TheRealMal/motor-controller/docs/src/Руководство_администратора.docx

Московский государственный технический университет им. Н.Э. Баумана

Контроллер шагового и асинхронного двигателей.

Руководство администратора.

РОФ.МГТУ.000001-01 5

Подп. и дата
Инв. N дубл.
Взам. Инв. N
Подп. и дата
Инв. N подп.

Листов 4

Проверил | | | Рафиков А.Г.
| | (подпись, дата)

Разработал | | | Малютин Р.С.
| | (подпись, дата)

| | | Храпов Н.А.
| | (подпись, дата)

ОГЛАВЛЕНИЕ

1 НАЗНАЧЕНИЕ И УСЛОВИЯ ПРИМЕНЕНИЯ ПРОГРАММЫ

  1.1 Назначение программы

Основной функцией программы является управление шаговым и асинхронным двигателем.

Основная задача программы – реализация универсального управления двигателями.

Программа реализует следующие функции:

Исходным языком программирования для аппаратной программы является C. Программа обеспечивает обработку команд и управление шаговым и асинхронным двигателями.

Программа реализует следующие функции:

- вращение двигателей в заданном пользователем направлении
- вращение двигателей заданной пользователем скоростью
- поворот двигателей на определенный пользователем угол

Функции программы позволяют обеспечить работу системы в автономном режиме.

  1.2 Условия, необходимые для выполнения программы
    1.2.1 Требования к составу периферийных устройств

Для функционирования ПО и взаимодействия с ПО требуется наличие локальной вычислительной сети.

    1.2.2 Требования к параметрам периферийных устройств

Никаких требований к параметрам периферийных устройств программа не предъявляет.

    1.2.3 Требования к программному обеспечению

Для запуска веб-интерфейса требуется ОС любого семейства с наличием веб-браузера (Chrome, Firefox и т.п.).

1 ВЫПОЛНЕНИЕ ПРОГРАММЫ

Для выполнения программы необходимо подключить питание к аппаратному устройству, программа будет работать в автономном режиме.

Для управления одним из двигателей необходимо отправить TCP запрос на устройство, что можно сделать, используя разработанный интерфейс.

2 ОБРАЩЕНИЕ К ПРОГРАММЕ
  2.1 Настройка информационной системы

Администратору для настройки необходимо осуществить следующие действия:

- Убедиться в доступности локальной вычислительной сети
- Заранее сконфигурировать данную сеть, либо получить учетные данные для доступа к ней
- Запустить устройство и определить его IP адрес
- Ввести определенный IP адрес в интерфейсе

При отсутствие установить веб-браузер на устройство, с которого будет происходить управление через веб-интерфейс.

  2.2 Завершение работы программы

Программа завершает работу при выключении устройства.

3 СООБЩЕНИЯ АДМИНИСТРАТОРУ

Сообщения аналогичны сообщениям описанным в документе “Руководство пользователя”
