TheRealMal/motor-controller/docs/Структурная_схема_ПО.pdf

| | | | РОФ.МГТУ.00001.001 СС
| | | | | Лит. | Масса | Масштаб
Изм. Лист | № докум. | Подп. | Дата
Разраб.
Пров. | Рафиков А.Г.
Т.контр. | | | | Лист | Листов 1
| | | | МГТУ им. Н.Э. Баумана ИУ8-72
Н.контр.
Утв.
Копировал: | Формат А3

## main

## SPI_Ethernet_doPacket

## parse_command

motor_type | handle_stepper

## handle_async

## команда для шагового двигателя

## команда для асинхронного двигателя

## статус выполнения
