TheRealMal/motor-controller/docs/РОФ_МГТУ_00001_001_01_Схема_электрическая_структурная.pdf

| | | | РОФ.МГТУ.00001.001
| | | | | Лит. | Масса | Масштаб
Изм. Лист | № докум. | Подп. | Дата
Разраб.
Пров. | Рафиков А.Г.
Т.контр. | | | | Лист | Листов 1
| | | | МГТУ им. Н.Э. Баумана ИУ8-72
Н.контр.
Утв.
Копировал: | Формат А3

# Микроконтроллер PIC18F45K22

# ENC28J60

# Шаговый двигатель

# Асинхронный двигатель

Обратная связь

Обратная связь

Сигнал для управления
асинхронным двигателем

Сигнал для управления
шаговым двигателем Результаты выполнения команд

Команды для
двигателей
