TheRealMal/motor-controller/docs/МГТУ_000001_001_ЭЗ.pdf

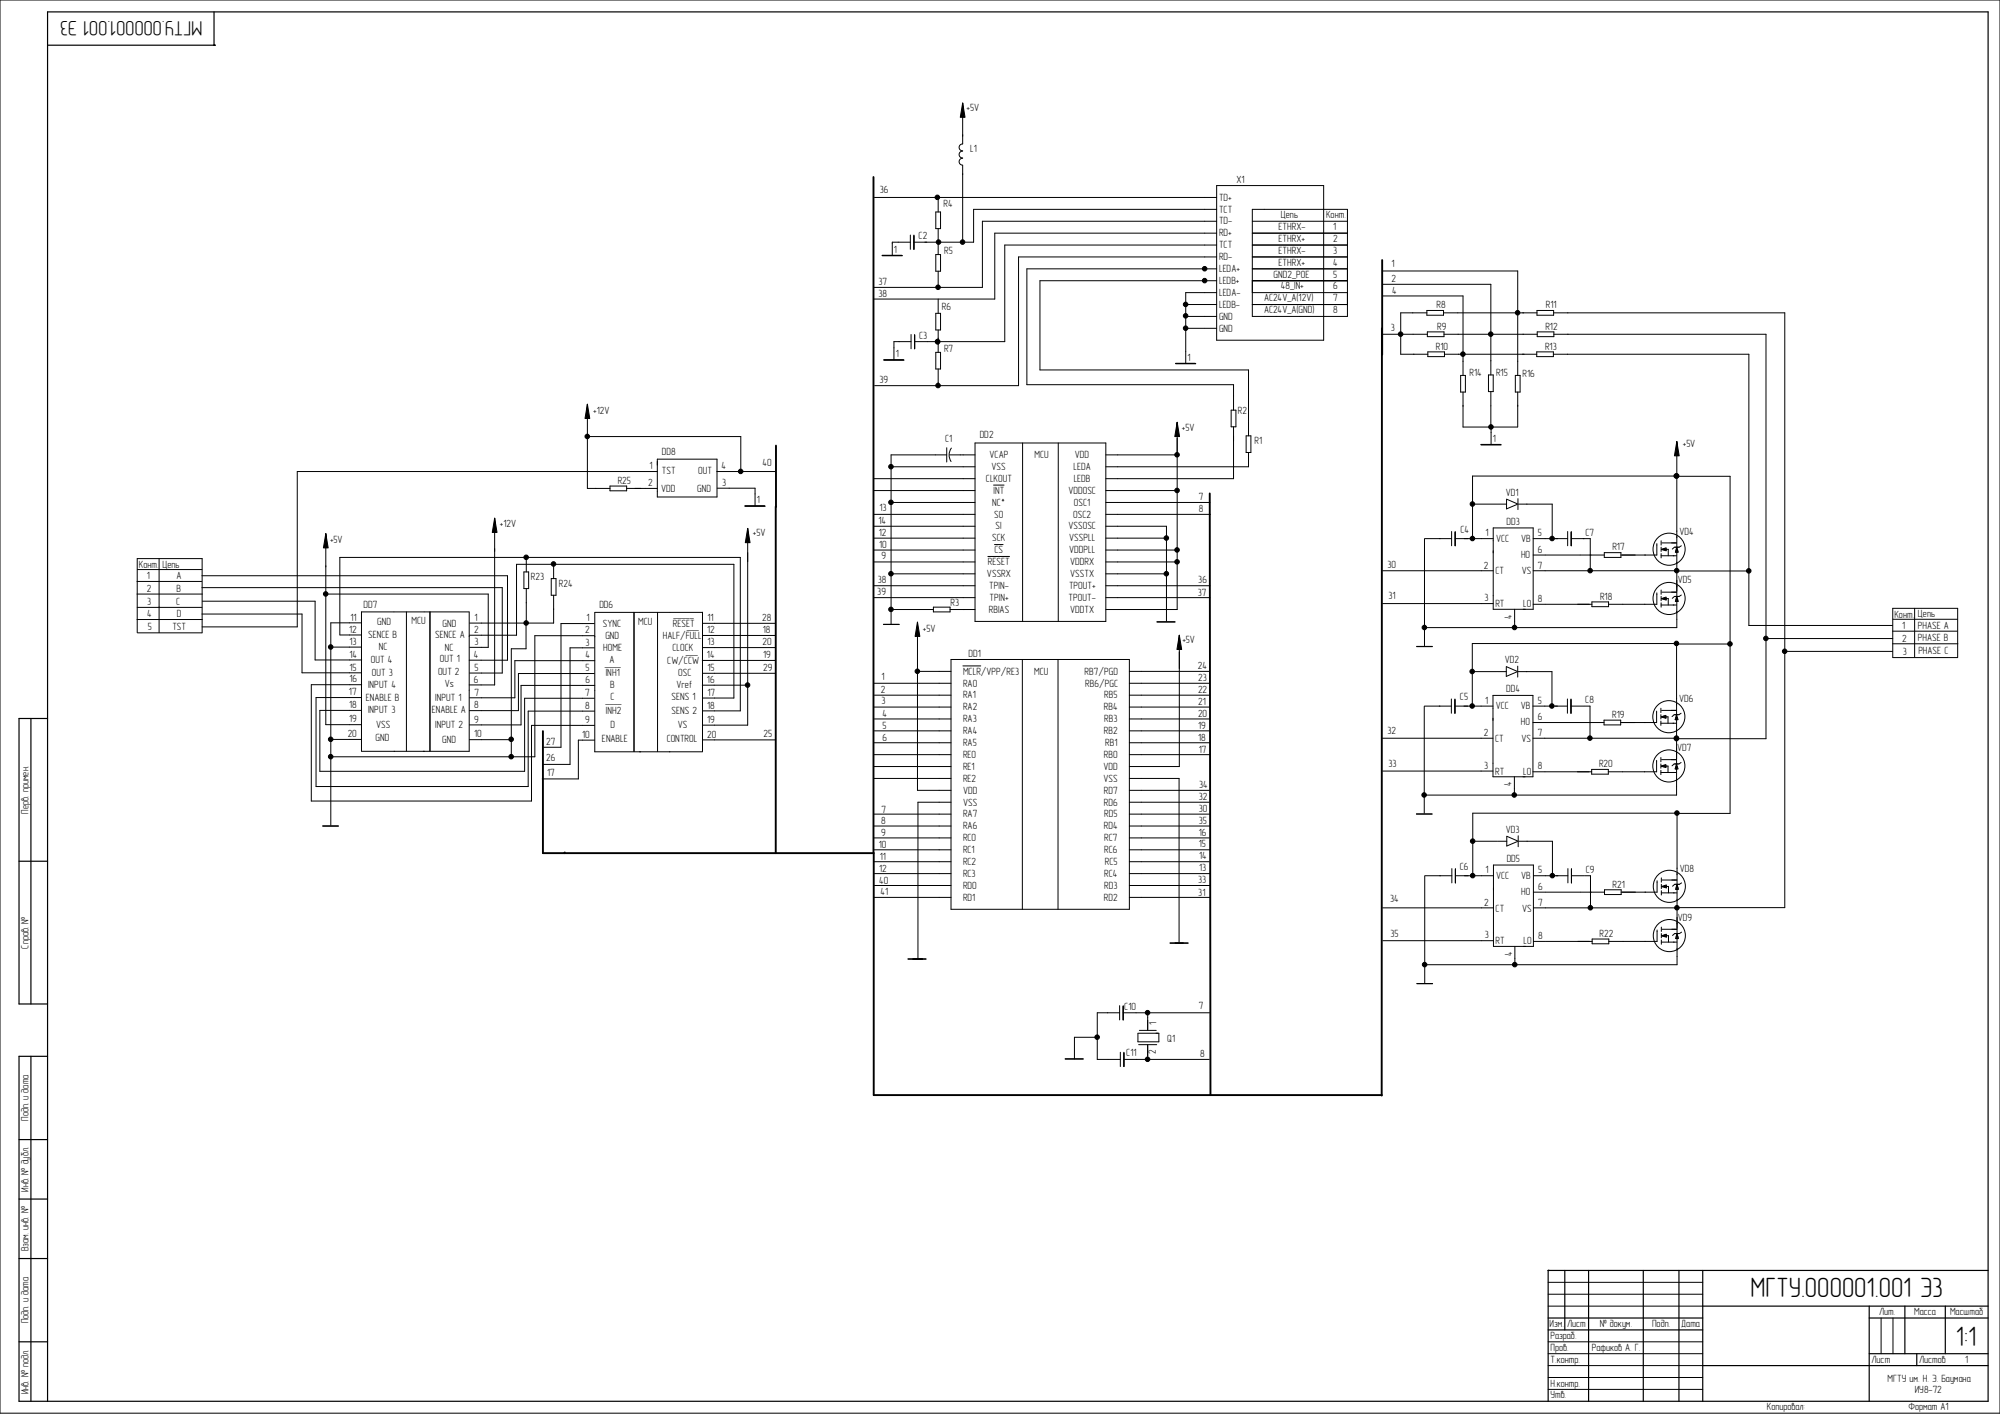
[picture p4: page 1]

Цепь ETHRX+ | Конт. 12345678
ETHRX-

ETHRX+

AC24V_A(12V)
AC24V_A(GND)

VCAP VSS CLKOUT | MCU | VDD LEDA LEDB VDDOSC OSC1 OSC2 VSSOSC VSSPLL VDDPLL VDDRX VSSTX TPOUT+ TPOUT-VDDTX

13
14 | | 36

ABC

19
18
17

32
30

10 | | 15
11 | | 14

МГТУ.000001.001 Э3

Лит. | Масса | Масштаб

Изм. Лист | № докум. | Подп. | Дата
Разраб.
Пров.
Т.контр. | | | | | 1

Н.контр.
Утв.

МГТУ им. Н. Э. Баумана ИУ8-72
