TheRealMal/motor-controller/docs/МГТУ_000001_001_Спецификация.PDF

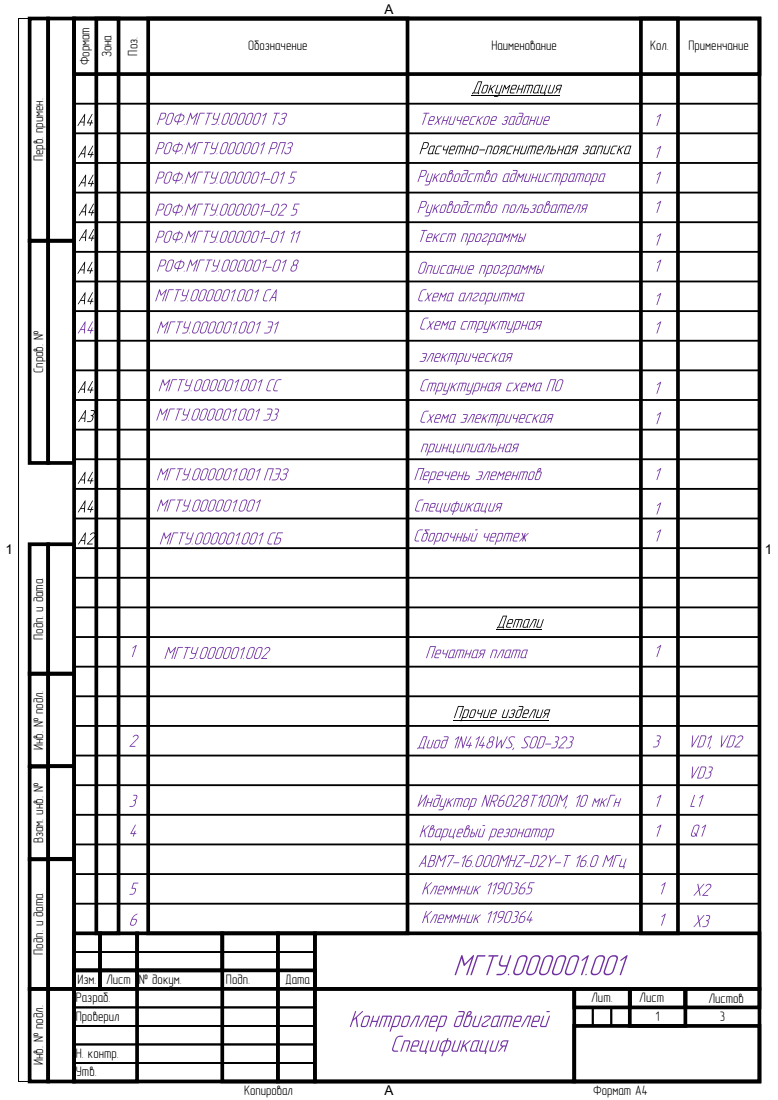
[picture p5: page 1]

Перв. примен. Справ. № Подп. и дата Инв. № подл. Взам. инв. № Подп. и дата Инв. № подл.

Изм. | Лист | № докум. | Подп. | Дата
Разраб. | | | Лит. | Лист | Листов
Проверил

Н. контр.
Утв.

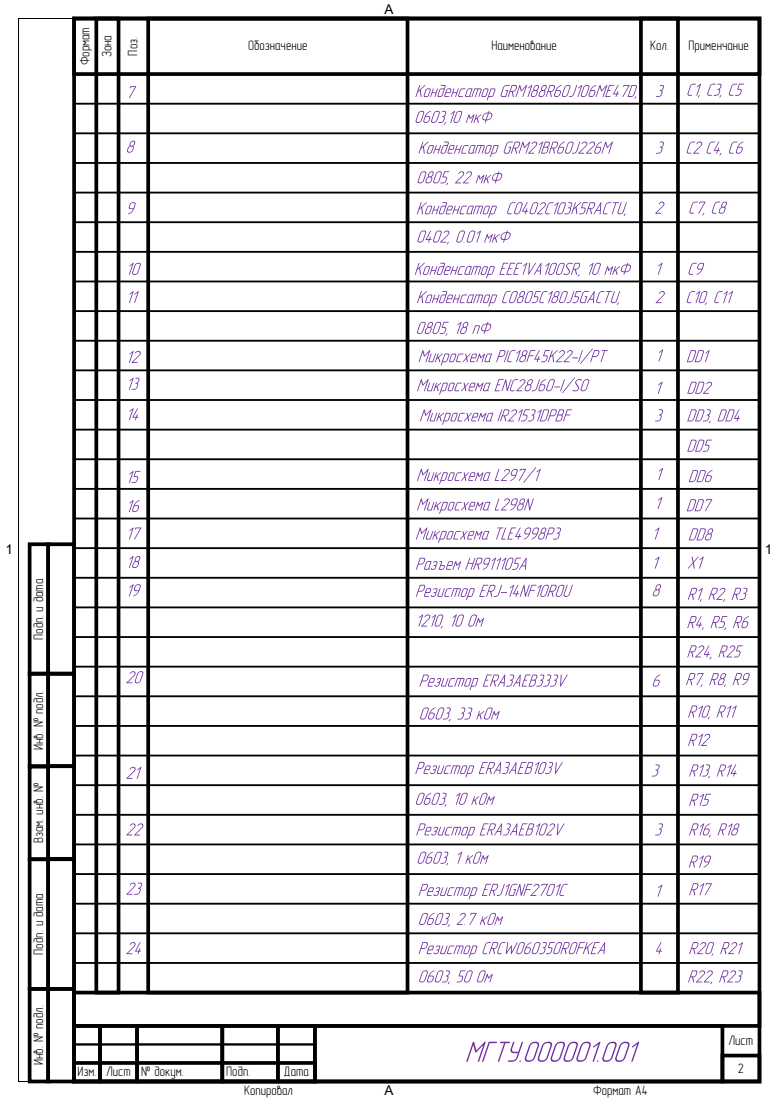
[picture p6: page 2]

Подп. и дата Инв. № подл. Взам. инв. № Подп. и дата Инв. № подл.

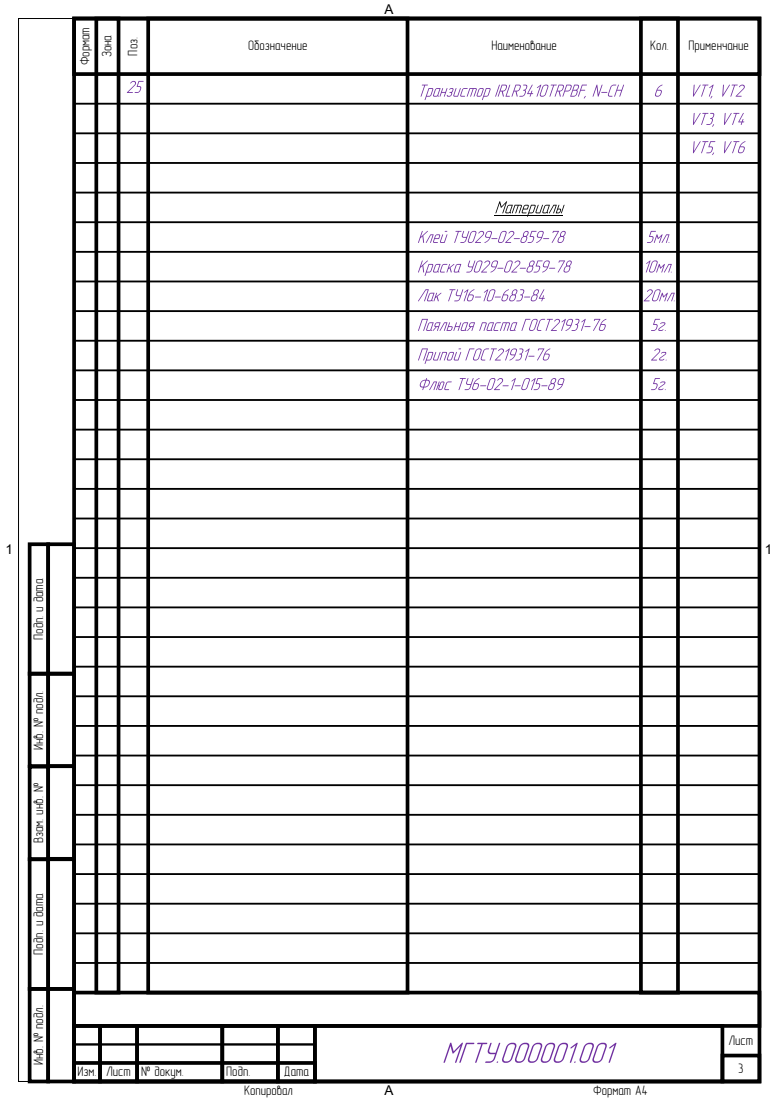
[picture p7: page 3]

Подп. и дата Инв. № подл. Взам. инв. № Подп. и дата Инв. № подл.
