TheRealMal/motor-controller/docs/МГТУ_000001_001_CБ.PDF

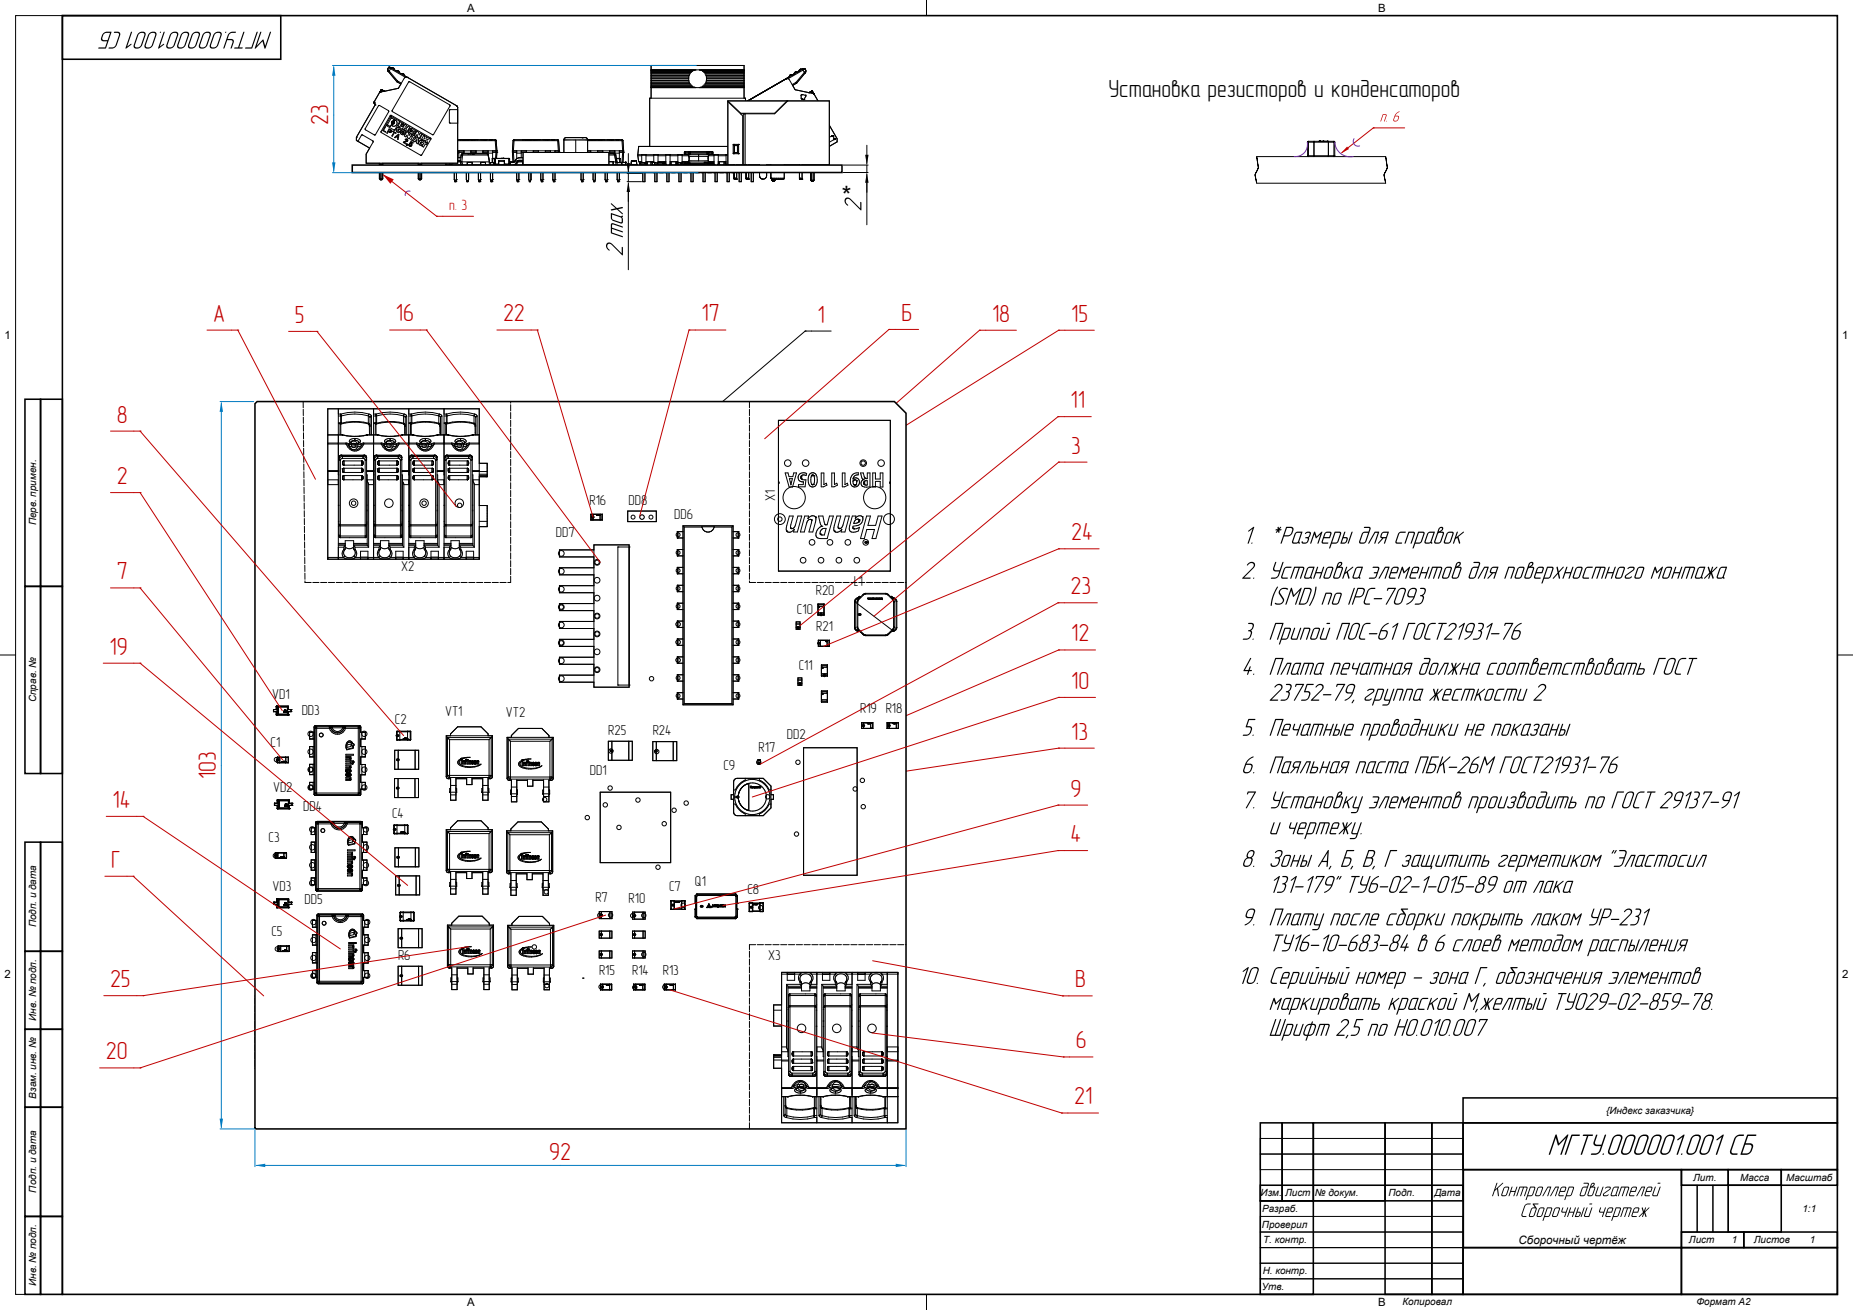
[picture p8: page 1]

Перв. примен. Справ. № Подп. и дата Инв. № подл. Взам. инв. № Подп. и дата Инв. № подл.
