TheRealMal/motor-controller/docs/МГТУ_000001_001_ПЭЗ.PDF

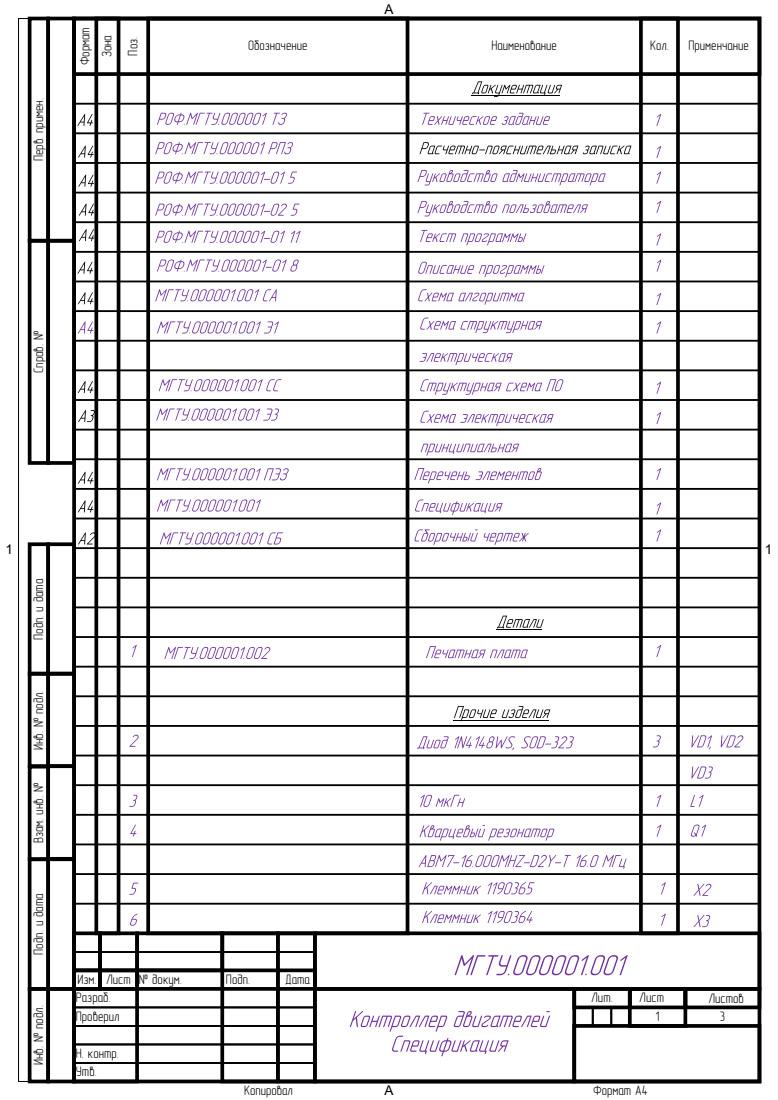
[picture p9: page 1]

Перв. примен. Справ. № Подп. и дата Инв. № подл. Взам. инв. № Подп. и дата Инв. № подл.

Изм. | Лист | № докум. | Подп. | Дата
Разраб. | | | Лит. | Лист | Листов
Проверил

Н. контр.
Утв.


Подп. и дата Инв. № подл. Взам. инв. № Подп. и дата Инв. № подл.


Подп. и дата Инв. № подл. Взам. инв. № Подп. и дата Инв. № подл.
