TheRealMal/motor-controller/docs/МГТУ_000001_002_ПП.pdf

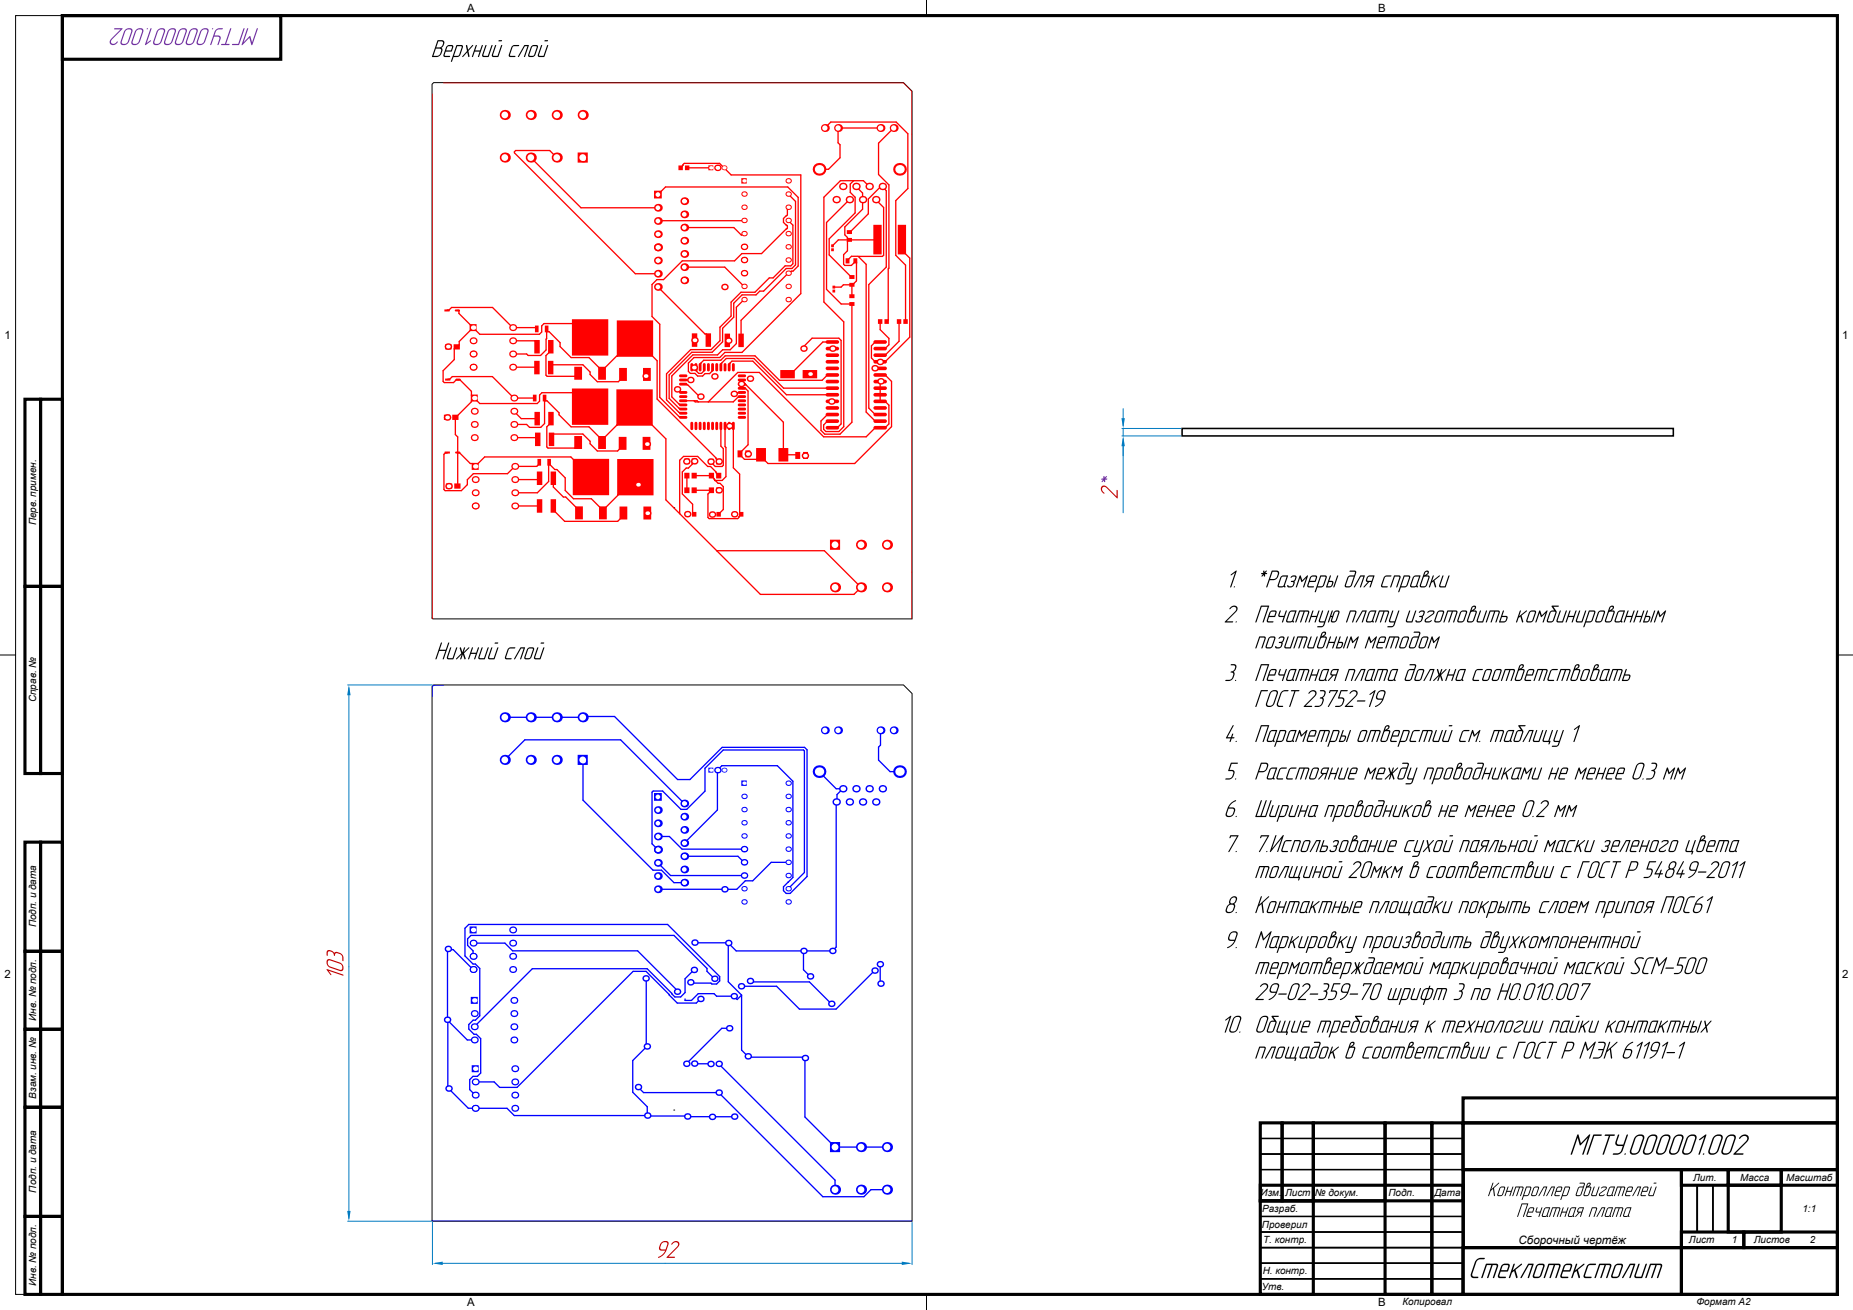
[picture p10: page 1]

Перв. примен. Справ. № Подп. и дата Инв. № подл. Взам. инв. № Подп. и дата Инв. № подл.

Сборочный чертёж | Лит. | Масса | Масштаб

Изм. Лист | № докум. | Подп. | Дата
Разраб.
Проверил
Т. контр. | | | | Лист 1 | Листов 2

Н. контр.
Утв.

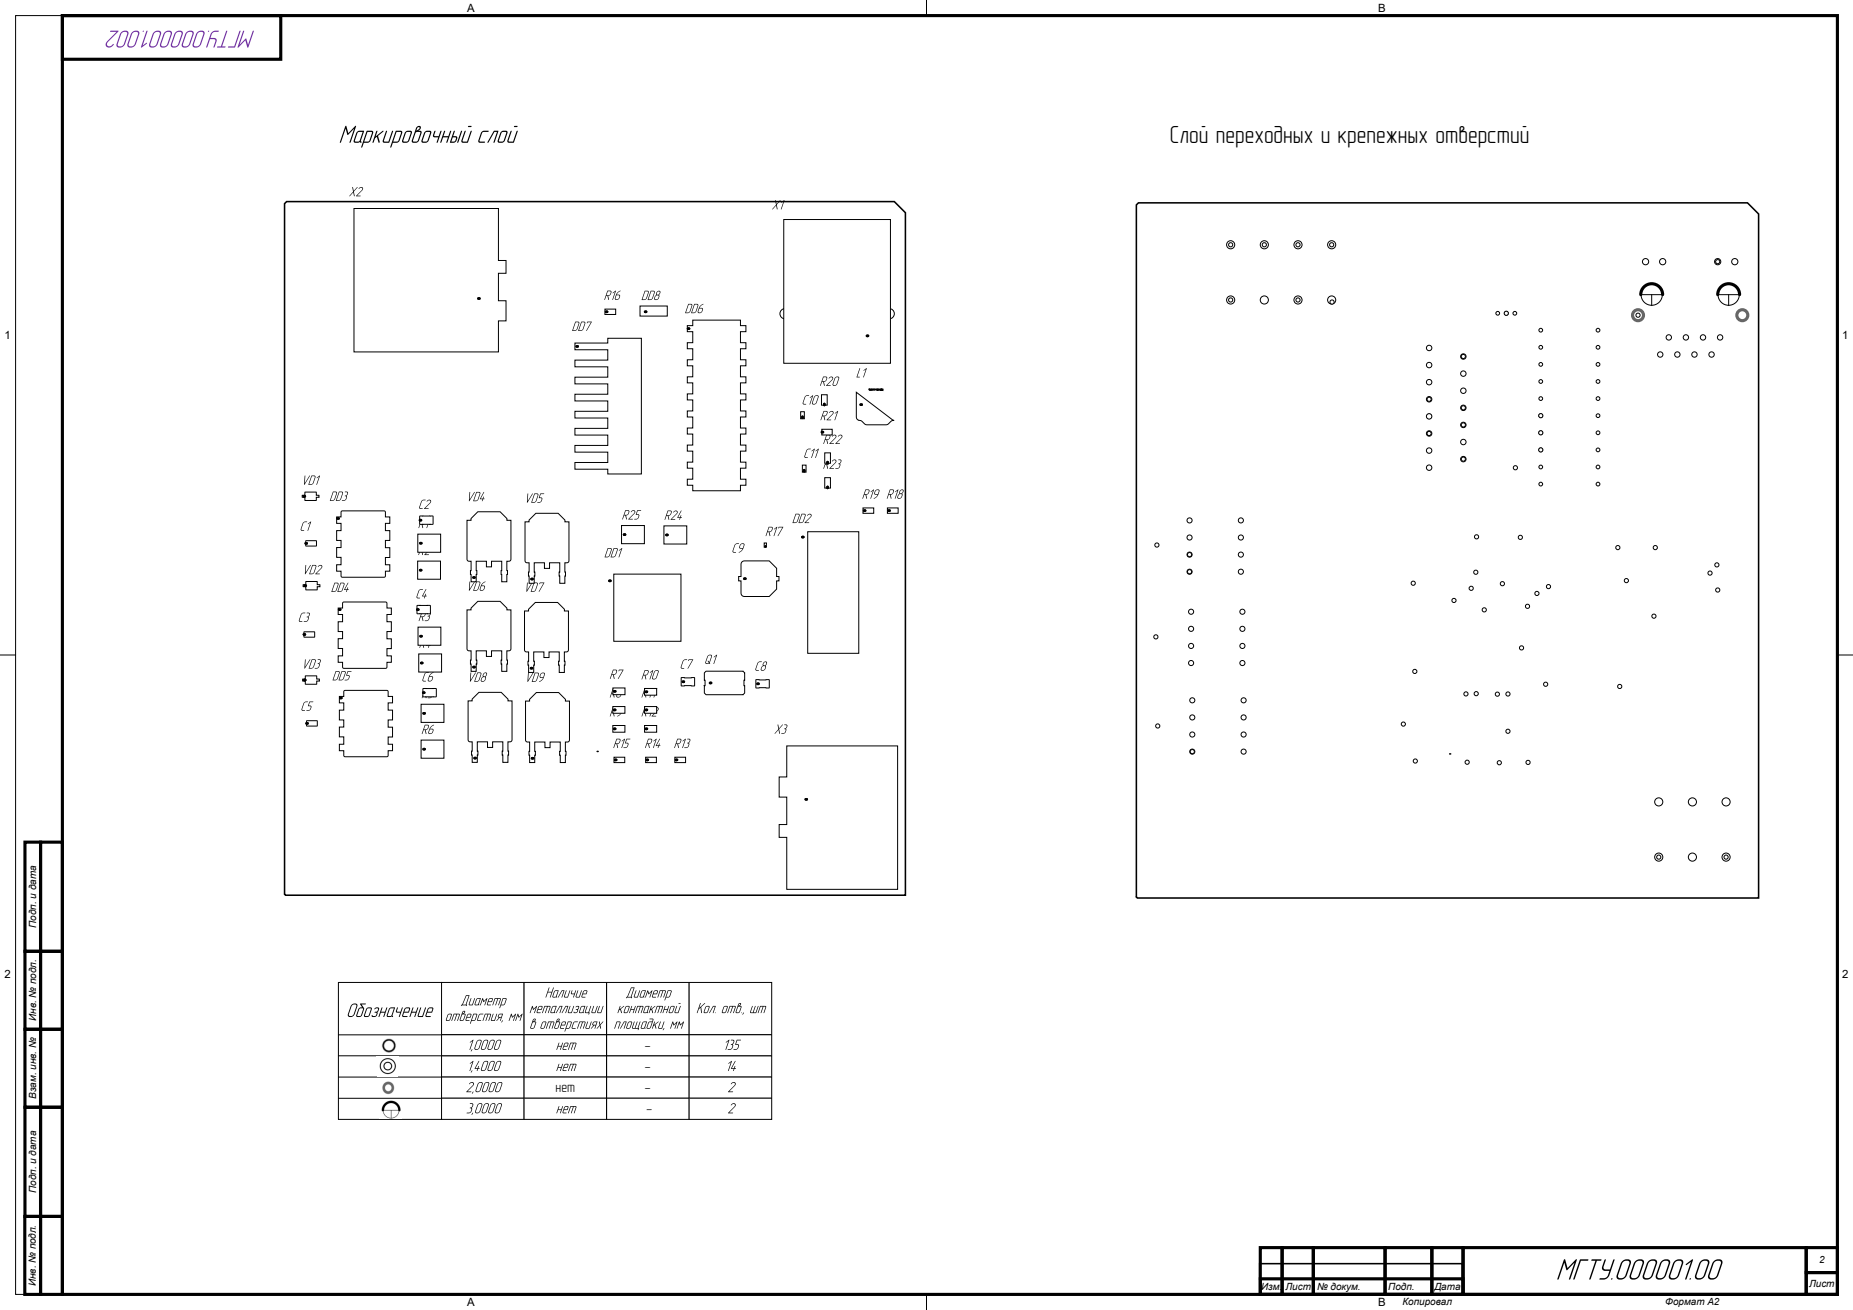
[picture p11: page 2]

Слой переходных и крепежных отверстий

Подп. и дата Взам. инв. № Подп. и дата Инв. № подл.

нет
