TheRealMal/motor-controller/(list of files, drawings)

Other design files:
src/scheme/main.pdsprj
