TheRealMal/motor-controller/(commit log)

2024-03-17 Scheme & Source code
    [main.pdsprj]
2024-03-18 update docs +спецификация +перечень
